Lambosaurus/Puzzlebox-HW/puzzlebox-main/Puzzlebox-HW.kicad_pcb

## KiCad design puzzlebox-main/Puzzlebox-HW.kicad_pcb (2025-12-28)

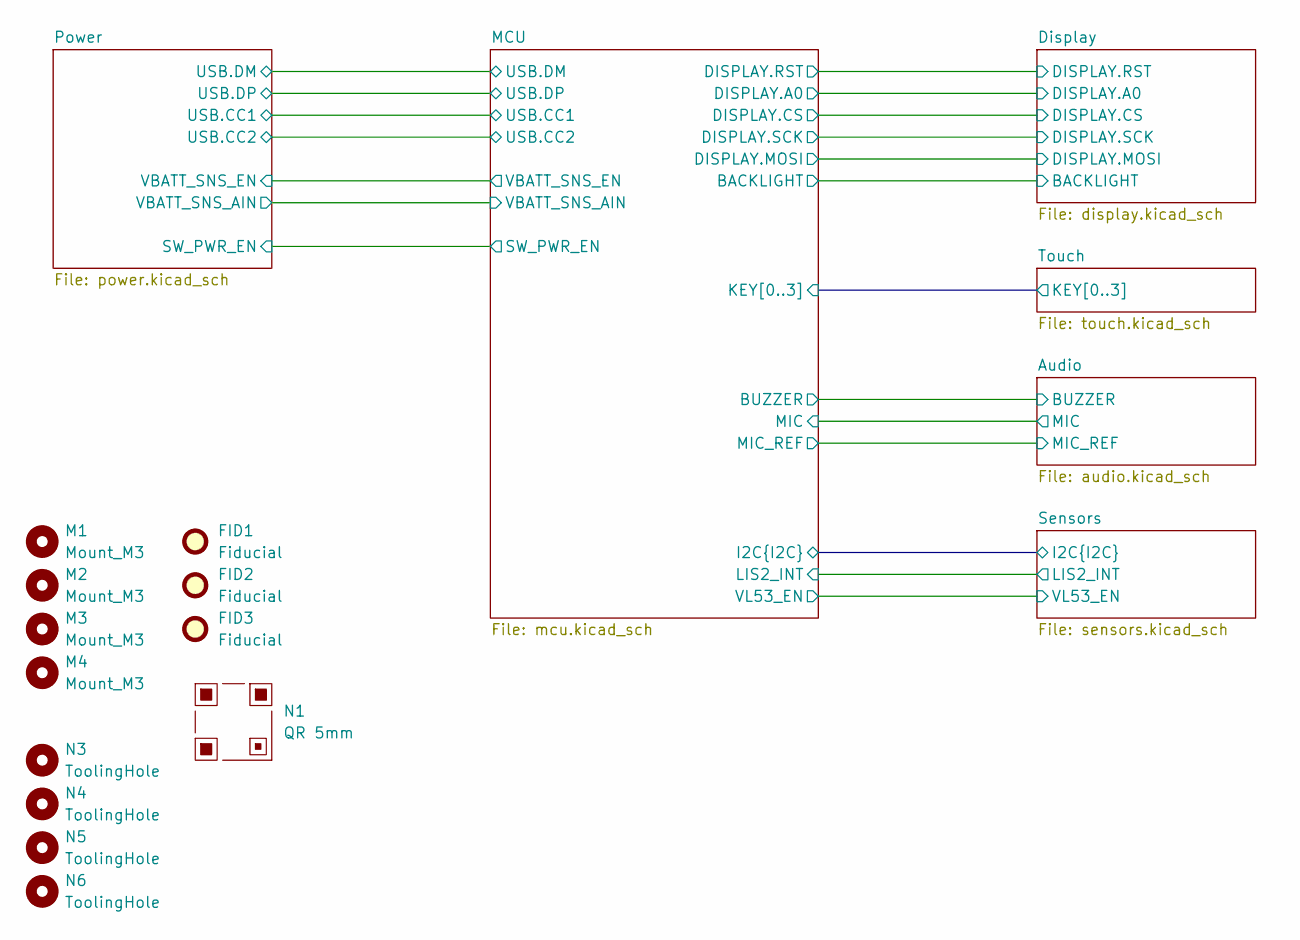
[picture p1: schematic Puzzlebox-HW.kicad_sch, Puzzlebox]

Parts:
FID1, FID2, FID3: Fiducial; Fiducial_2mm
M1, M2, M3, M4: Mount_M3
N1: QR 5mm; QR_5mm_JLC
N3, N4, N5, N6: ToolingHole; ToolingHole_1mm

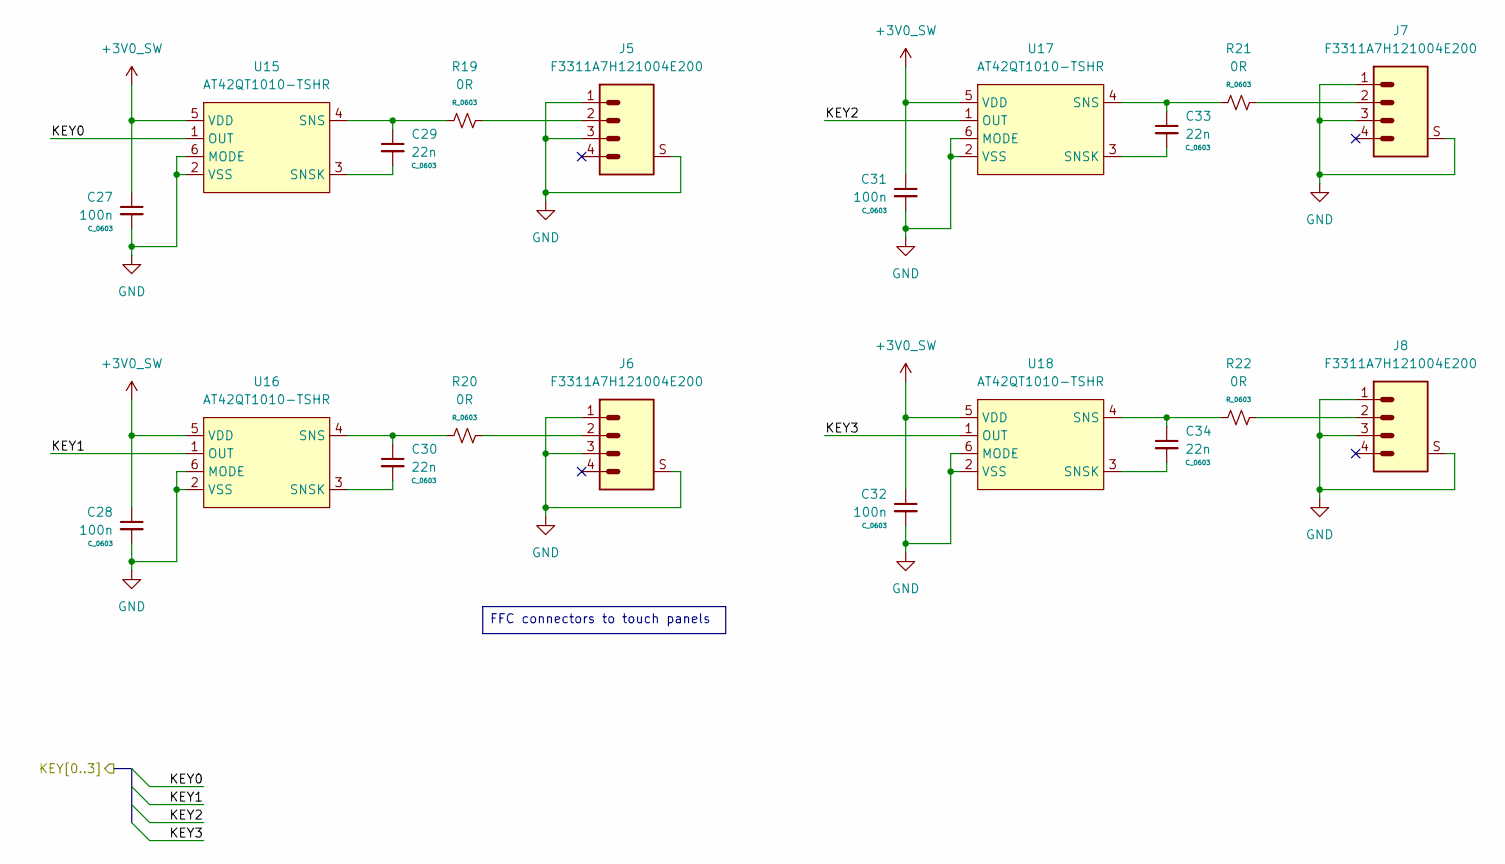
[picture p2: schematic touch.kicad_sch, Puzzlebox]

Parts:
C27, C28, C31, C32: 100n; C_0603
C29, C30, C33, C34: 22n; C_0603
J5, J6, J7, J8: F3311A7H121004E200
R19, R20, R21, R22: 0R; R_0603
U15, U16, U17, U18: AT42QT1010-TSHR; SOT23_6

Connections:
+3V0_SW: C27.1, C28.1, C31.1, C32.1, U15.5 (VDD), U16.5 (VDD), U17.5 (VDD), U18.5 (VDD); also elsewhere on the board
/MCU/KEY0: U15.1 (OUT); also elsewhere on the board
/MCU/KEY1: U16.1 (OUT); also elsewhere on the board
/MCU/KEY2: U17.1 (OUT); also elsewhere on the board
/MCU/KEY3: U18.1 (OUT); also elsewhere on the board
GND: C27.2, C28.2, C31.2, C32.2, J5.1, J5.3, J5.S, J6.1, J6.3, J6.S, J7.1, J7.3, J7.S, J8.1, J8.3, J8.S, U15.2 (VSS), U15.6 (MODE), U16.2 (VSS), U16.6 (MODE), U17.2 (VSS), U17.6 (MODE), U18.2 (VSS), U18.6 (MODE); also elsewhere on the board
unnamed: J5.2, R19.2
unnamed: J6.2, R20.2
unnamed: J7.2, R21.2
unnamed: J8.2, R22.2
unnamed: C29.1, R19.1, U15.4 (SNS)
unnamed: C29.2, U15.3 (SNSK)
unnamed: C30.1, R20.1, U16.4 (SNS)
unnamed: C30.2, U16.3 (SNSK)
unnamed: C33.1, R21.1, U17.4 (SNS)
unnamed: C33.2, U17.3 (SNSK)
unnamed: C34.1, R22.1, U18.4 (SNS)
unnamed: C34.2, U18.3 (SNSK)

Notes on the sheet:
FFC connectors to touch panels

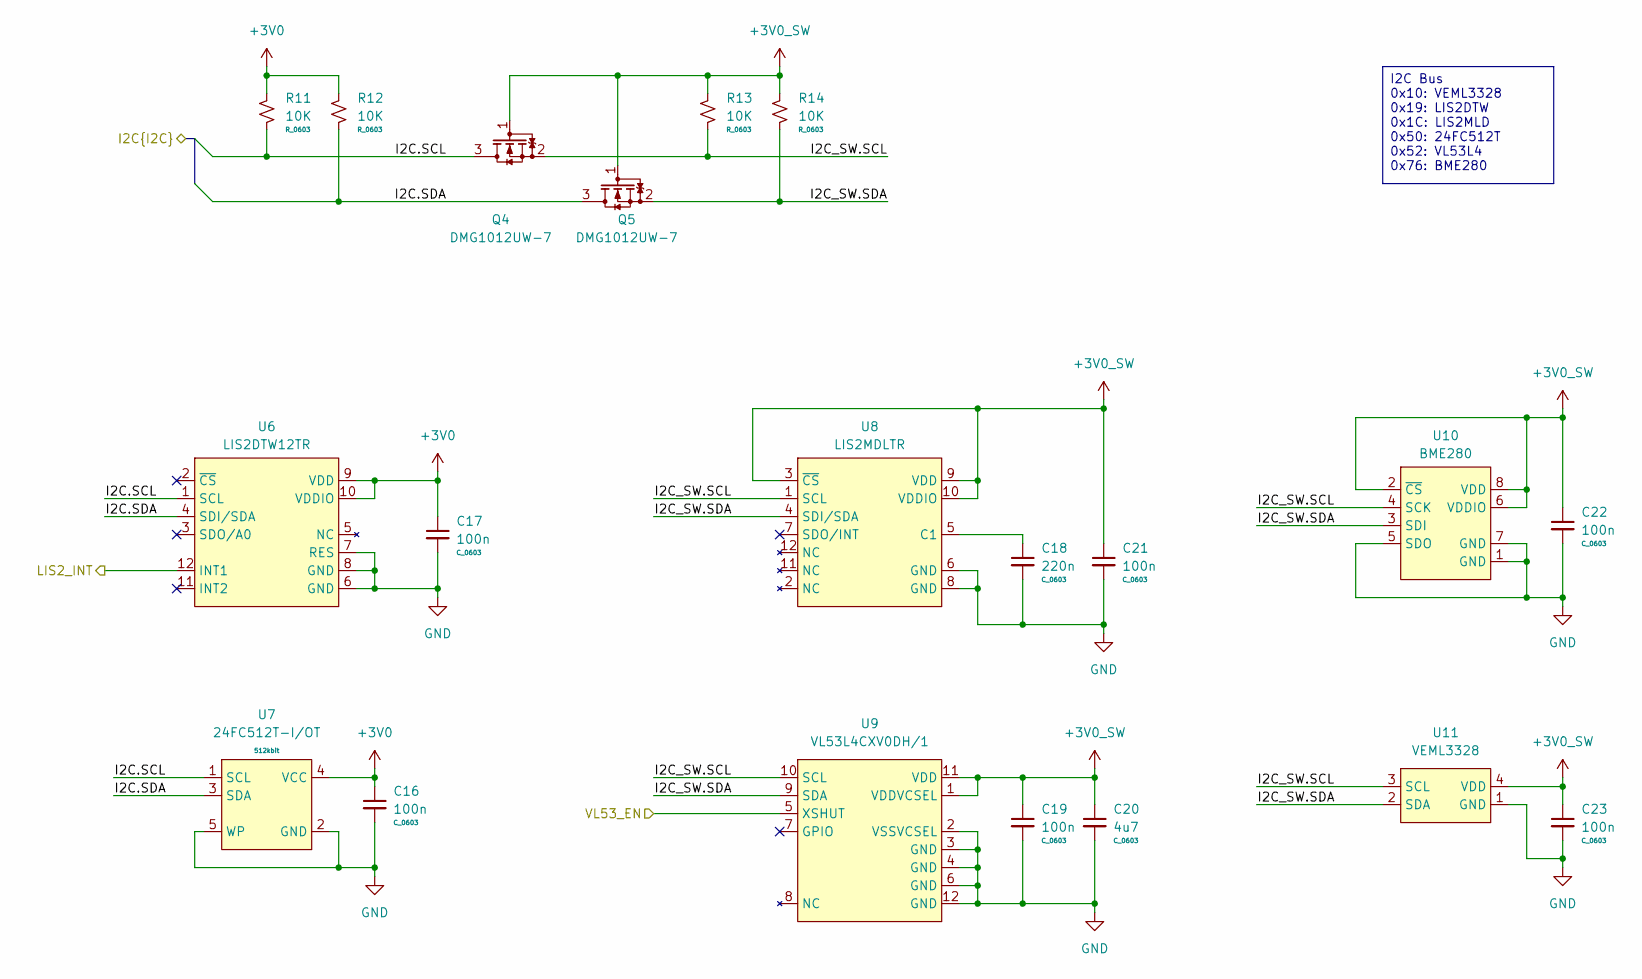
[picture p3: schematic sensors.kicad_sch, Puzzlebox]

Parts:
C16, C17, C19, C21, C22, C23: 100n; C_0603
C18: 220n; C_0603
C20: 4u7; C_0603
Q4, Q5: DMG1012UW-7; SC70-3
R11, R12, R13, R14: 10K; R_0603
U6: LIS2DTW12TR; LGA12_05_2x2_ST
U7: 24FC512T-I/OT; SOT23_5
U8: LIS2MDLTR; LGA12_05_2x2_ST
U9: VL53L4CXV0DH/1; ST_VL53Lxx
U10: BME280; LGA8_025_2.5x1_Bosch
U11: VEML3328; Vishay_80216OPLGA4L

Connections:
+3V0: C16.1, C17.1, R11.1, R12.1, U6.9 (VDD), U6.10 (VDDIO), U7.4 (VCC); also elsewhere on the board
+3V0_SW: C19.1, C20.1, C21.1, C22.1, C23.1, Q4.1 (G), Q5.1 (G), R13.1, R14.1, U8.3 (~CS), U8.9 (VDD), U8.10 (VDDIO), U9.1 (VDDVCSEL), U9.11 (VDD), U10.2 (~CS), U10.6 (VDDIO), U10.8 (VDD), U11.4 (VDD); also elsewhere on the board
/MCU/I2C.SCL: Q4.3 (D), R11.2, U6.1 (SCL), U7.1 (SCL); also elsewhere on the board
/MCU/I2C.SDA: Q5.3 (D), R12.2, U6.4 (SDI/SDA), U7.3 (SDA); also elsewhere on the board
/MCU/LIS2_INT: U6.12 (INT1); also elsewhere on the board
/MCU/VL53_EN: U9.5 (XSHUT); also elsewhere on the board
/Sensors/I2C_SW.SCL: Q4.2 (S), R13.2, U8.1 (SCL), U9.10 (SCL), U10.4 (SCK), U11.3 (SCL)
/Sensors/I2C_SW.SDA: Q5.2 (S), R14.2, U8.4 (SDI/SDA), U9.9 (SDA), U10.3 (SDI), U11.2 (SDA)
GND: C16.2, C17.2, C18.2, C19.2, C20.2, C21.2, C22.2, C23.2, U6.6 (GND), U6.7 (RES), U6.8 (GND), U7.2 (GND), U7.5 (WP), U8.6 (GND), U8.8 (GND), U9.2 (VSSVCSEL), U9.3 (GND), U9.4 (GND), U9.6 (GND), U9.12 (GND), U10.1 (GND), U10.5 (SDO), U10.7 (GND), U11.1 (GND); also elsewhere on the board
unnamed: C18.1, U8.5 (C1)

Notes on the sheet:
I2C Bus 0x10: VEML3328 0x19: LIS2DTW 0x1C: LIS2MLD 0x50: 24FC512T 0x52: VL53L4 0x76: BME280

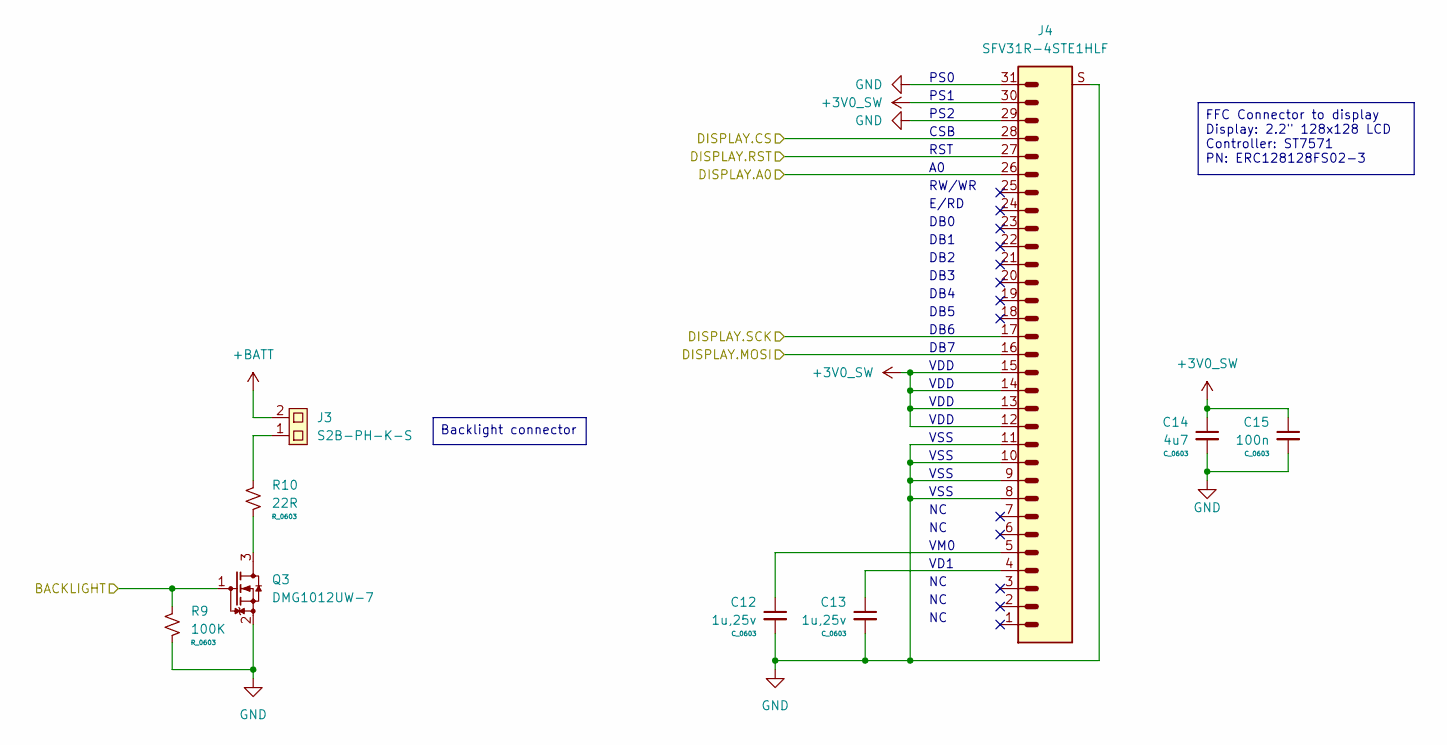
[picture p4: schematic display.kicad_sch, Puzzlebox]

Parts:
C12, C13: 1u,25v; C_0603
C14: 4u7; C_0603
C15: 100n; C_0603
J3: S2B-PH-K-S; JST-S2B-PH-K-S
J4: SFV31R-4STE1HLF
Q3: DMG1012UW-7; SC70-3
R9: 100K; R_0603
R10: 22R; R_0603

Connections:
+3V0_SW: C14.1, C15.1, J4.12, J4.13, J4.14, J4.15, J4.30; also elsewhere on the board
+BATT: J3.2; also elsewhere on the board
/Display/BACKLIGHT: Q3.1 (G), R9.1; also elsewhere on the board
/Display/DISPLAY.A0: J4.26; also elsewhere on the board
/Display/DISPLAY.CS: J4.28; also elsewhere on the board
/Display/DISPLAY.MOSI: J4.16; also elsewhere on the board
/Display/DISPLAY.RST: J4.27; also elsewhere on the board
/Display/DISPLAY.SCK: J4.17; also elsewhere on the board
GND: C12.2, C13.2, C14.2, C15.2, J4.8, J4.9, J4.10, J4.11, J4.29, J4.31, J4.S, Q3.2 (S), R9.2; also elsewhere on the board
unnamed: C12.1, J4.5
unnamed: C13.1, J4.4
unnamed: J3.1, R10.1
unnamed: Q3.3 (D), R10.2

Notes on the sheet:
PS0
E/RD
VSS
PS2
VM0
VD1
DB4
DB7
RST
DB6
RW/WR
PS1
DB0
VDD
DB1
DB3
DB2
DB5
CSB
FFC Connector to display Display: 2.2" 128x128 LCD Controller: ST7571 PN: ERC128128FS02-3
Backlight connector

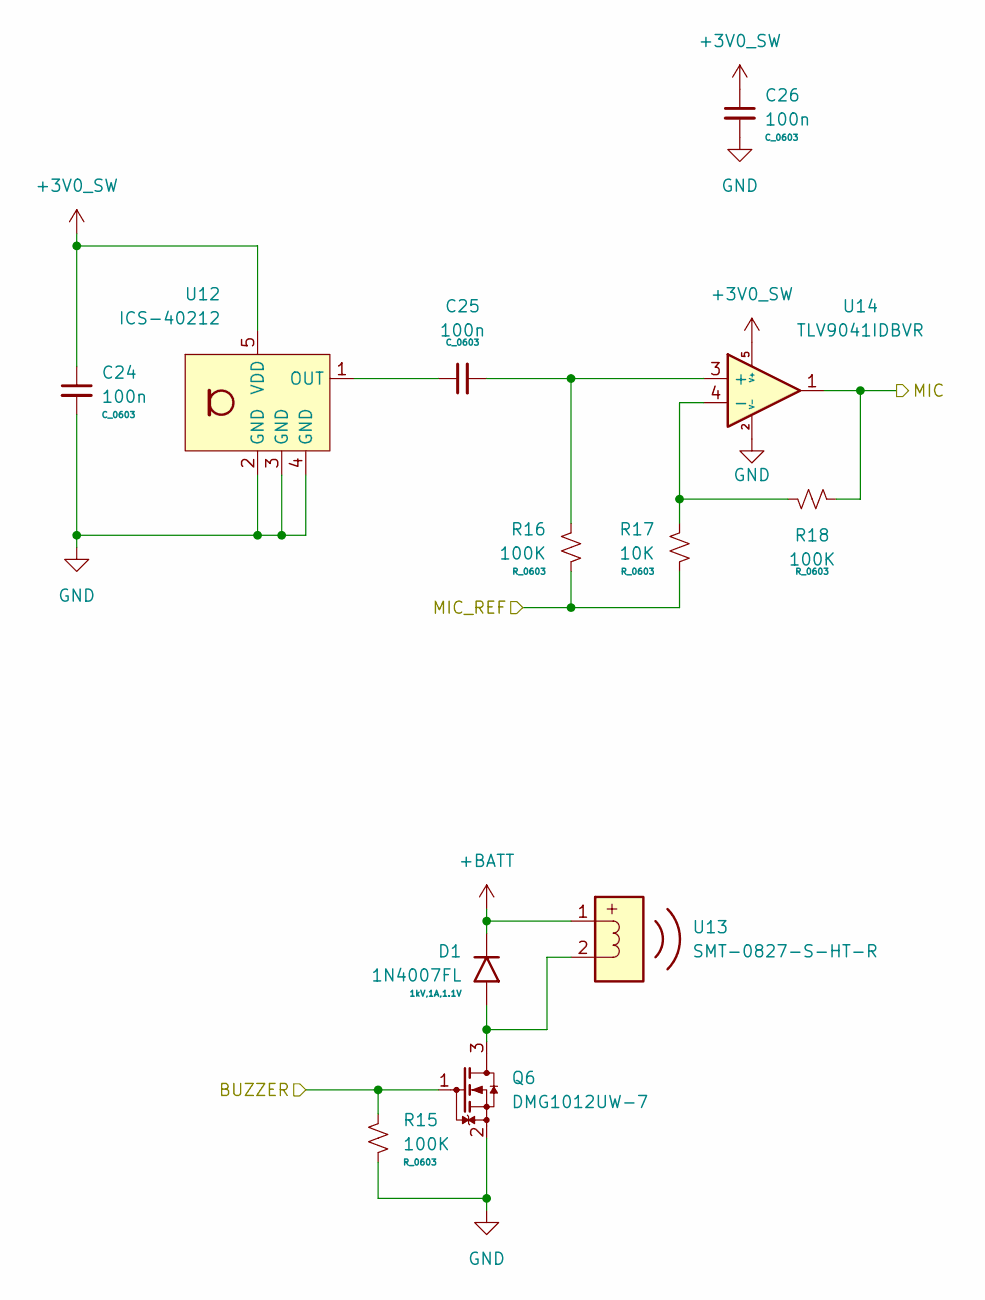
[picture p5: schematic audio.kicad_sch, Puzzlebox]

Parts:
C24, C25, C26: 100n; C_0603
D1: 1N4007FL; D_SOD_123
Q6: DMG1012UW-7; SC70-3
R15, R16, R18: 100K; R_0603
R17: 10K; R_0603
U12: ICS-40212
U13: SMT-0827-S-HT-R; SMT_0827_S_HT_R
U14: TLV9041IDBVR; SOT23_5

Connections:
+3V0_SW: C24.1, C26.1, U12.5 (VDD), U14.5 (V+); also elsewhere on the board
+BATT: D1.1, U13.1; also elsewhere on the board
/Audio/BUZZER: Q6.1 (G), R15.1; also elsewhere on the board
/Audio/MIC: R18.2, U14.1; also elsewhere on the board
/Audio/MIC_REF: R16.2, R17.1; also elsewhere on the board
GND: C24.2, C26.2, Q6.2 (S), R15.2, U12.2 (GND), U12.3 (GND), U12.4 (GND), U14.2 (V-); also elsewhere on the board
unnamed: D1.2, Q6.3 (D), U13.2
unnamed: C25.1, U12.1 (OUT)
unnamed: C25.2, R16.1, U14.3 (+)
unnamed: R17.2, R18.1, U14.4 (-)

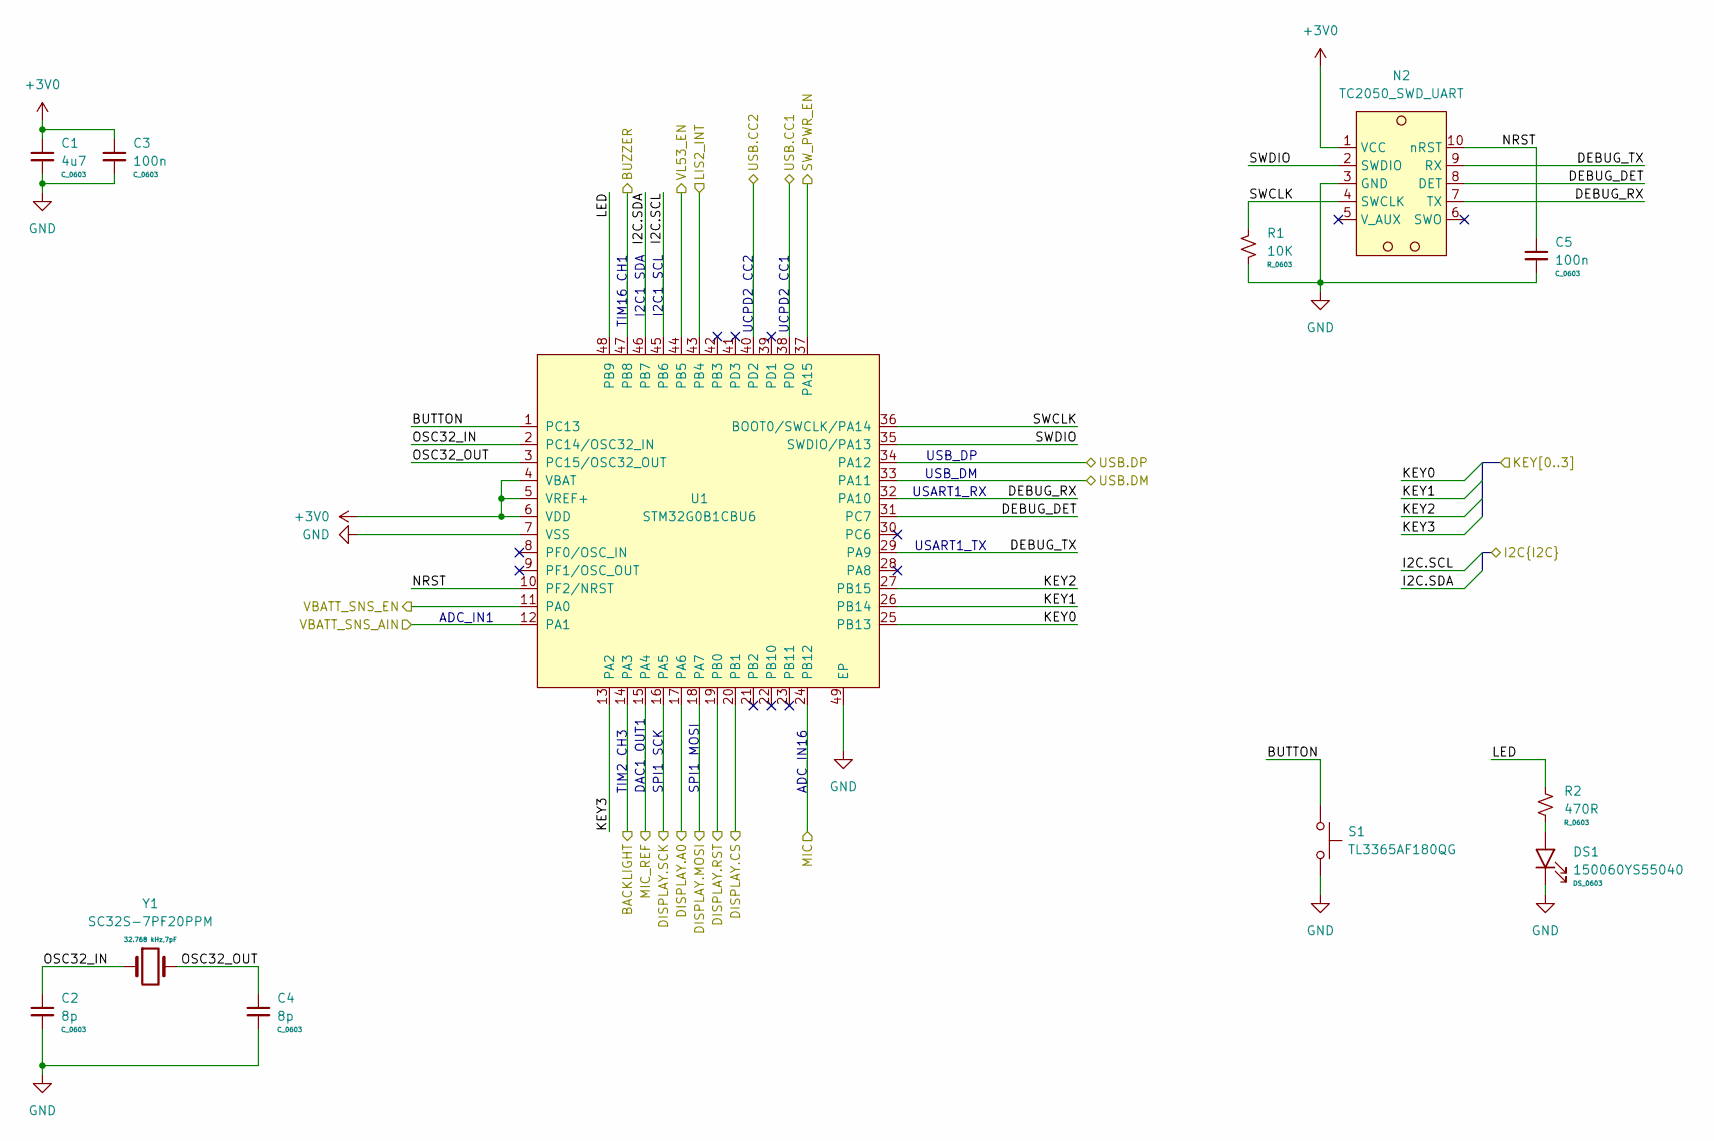
[picture p6: schematic mcu.kicad_sch, Puzzlebox]

Parts:
C1: 4u7; C_0603
C2, C4: 8p; C_0603
C3, C5: 100n; C_0603
DS1: 150060YS55040; DS_0603
N2: TC2050_SWD_UART; TagConnect_TC2050
R1: 10K; R_0603
R2: 470R; R_0603
S1: TL3365AF180QG; Button_4.2x3.2
U1: STM32G0B1CBU6; QFN48_05_7x7_EP
Y1: SC32S-7PF20PPM; Crystal_SMD2_3.2x1.5

Connections:
+3V0: C1.1, C3.1, N2.1 (VCC), U1.4 (VBAT), U1.5 (VREF+), U1.6 (VDD); also elsewhere on the board
/Audio/BUZZER: U1.47 (PB8); also elsewhere on the board
/Audio/MIC: U1.24 (PB12); also elsewhere on the board
/Audio/MIC_REF: U1.15 (PA4); also elsewhere on the board
/Display/BACKLIGHT: U1.14 (PA3); also elsewhere on the board
/Display/DISPLAY.A0: U1.17 (PA6); also elsewhere on the board
/Display/DISPLAY.CS: U1.20 (PB1); also elsewhere on the board
/Display/DISPLAY.MOSI: U1.18 (PA7); also elsewhere on the board
/Display/DISPLAY.RST: U1.19 (PB0); also elsewhere on the board
/Display/DISPLAY.SCK: U1.16 (PA5); also elsewhere on the board
/MCU/BUTTON: S1.1, U1.1 (PC13)
/MCU/DEBUG_DET: N2.8 (DET), U1.31 (PC7)
/MCU/DEBUG_RX: N2.7 (TX), U1.32 (PA10)
/MCU/DEBUG_TX: N2.9 (RX), U1.29 (PA9)
/MCU/I2C.SCL: U1.45 (PB6); also elsewhere on the board
/MCU/I2C.SDA: U1.46 (PB7); also elsewhere on the board
/MCU/KEY0: U1.25 (PB13); also elsewhere on the board
/MCU/KEY1: U1.26 (PB14); also elsewhere on the board
/MCU/KEY2: U1.27 (PB15); also elsewhere on the board
/MCU/KEY3: U1.13 (PA2); also elsewhere on the board
/MCU/LED: R2.1, U1.48 (PB9)
/MCU/LIS2_INT: U1.43 (PB4); also elsewhere on the board
/MCU/NRST: C5.1, N2.10 (nRST), U1.10 (PF2/NRST)
/MCU/OSC32_IN: C2.1, U1.2 (PC14/OSC32_IN), Y1.1
/MCU/OSC32_OUT: C4.1, U1.3 (PC15/OSC32_OUT), Y1.2
/MCU/SWCLK: N2.4 (SWCLK), R1.1, U1.36 (BOOT0/SWCLK/PA14)
/MCU/SWDIO: N2.2 (SWDIO), U1.35 (SWDIO/PA13)
/MCU/SW_PWR_EN: U1.37 (PA15); also elsewhere on the board
/MCU/USB.CC1: U1.38 (PD0); also elsewhere on the board
/MCU/USB.CC2: U1.40 (PD2); also elsewhere on the board
/MCU/USB.DM: U1.33 (PA11); also elsewhere on the board
/MCU/USB.DP: U1.34 (PA12); also elsewhere on the board
/MCU/VBATT_SNS_AIN: U1.12 (PA1); also elsewhere on the board
/MCU/VBATT_SNS_EN: U1.11 (PA0); also elsewhere on the board
/MCU/VL53_EN: U1.44 (PB5); also elsewhere on the board
GND: C1.2, C2.2, C3.2, C4.2, C5.2, DS1.1 (K), N2.3 (GND), R1.2, S1.2, U1.7 (VSS), U1.49 (EP); also elsewhere on the board
unnamed: DS1.2 (A), R2.2

Notes on the sheet:
UCPD2_CC1
SPI1_SCK
USB_DM
SPI1_MOSI
TIM16_CH1
UCPD2_CC2
ADC_IN1
USB_DP
DAC1_OUT1
TIM2_CH3
I2C1_SDA
I2C1_SCL
USART1_TX
USART1_RX
ADC_IN16

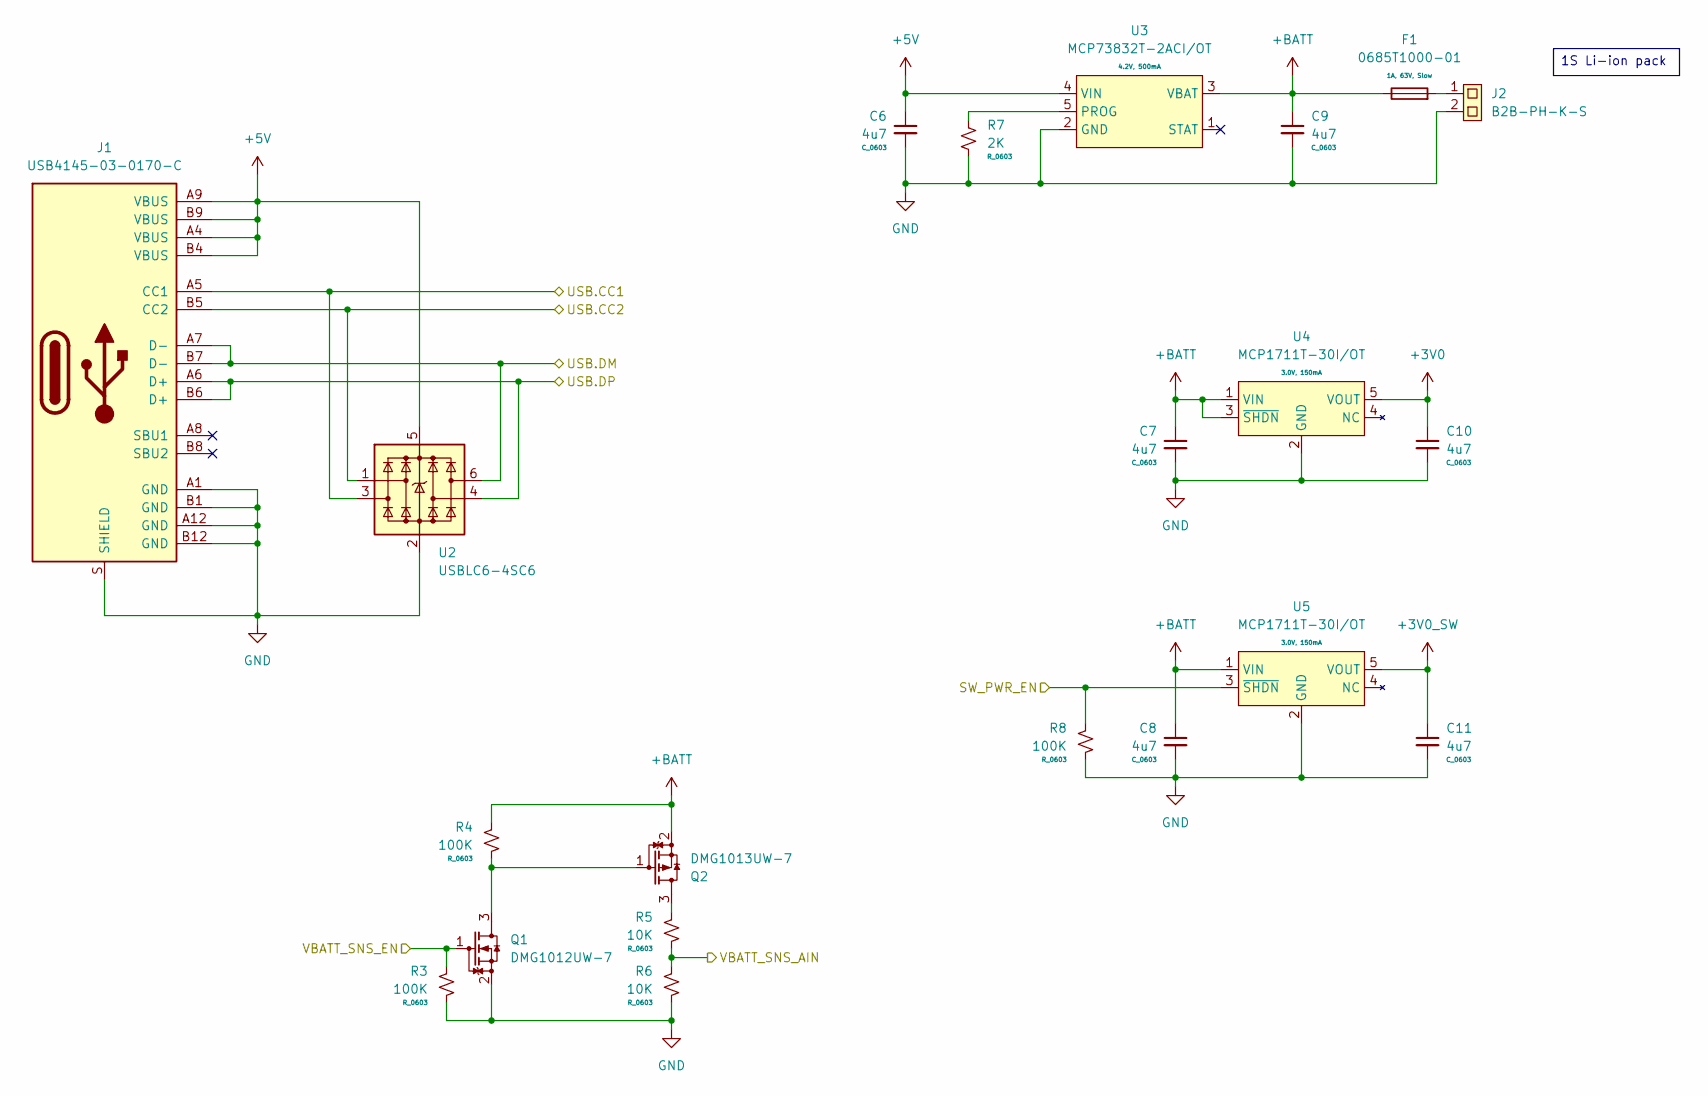
[picture p7: schematic power.kicad_sch, Puzzlebox]

Parts:
C6, C7, C8, C9, C10, C11: 4u7; C_0603
F1: 0685T1000-01; F_1206
J1: USB4145-03-0170-C; USB_C_USB4145-03-0170-C
J2: B2B-PH-K-S; JST_B2B-PH-K
Q1: DMG1012UW-7; SC70-3
Q2: DMG1013UW-7; SC70-3
R3, R4, R8: 100K; R_0603
R5, R6: 10K; R_0603
R7: 2K; R_0603
U2: USBLC6-4SC6; SOT23_6
U3: MCP73832T-2ACI/OT; SOT23_5
U4, U5: MCP1711T-30I/OT; SOT23_5

Connections:
+3V0: C10.1, U4.5 (VOUT); also elsewhere on the board
+3V0_SW: C11.1, U5.5 (VOUT); also elsewhere on the board
+5V: C6.1, J1.A4 (VBUS), J1.A9 (VBUS), J1.B4 (VBUS), J1.B9 (VBUS), U2.5, U3.4 (VIN)
+BATT: C7.1, C8.1, C9.1, F1.1, Q2.2 (S), R4.2, U3.3 (VBAT), U4.1 (VIN), U4.3 (~SHDN), U5.1 (VIN); also elsewhere on the board
/MCU/SW_PWR_EN: R8.2, U5.3 (~SHDN); also elsewhere on the board
/MCU/USB.CC1: J1.A5 (CC1), U2.3; also elsewhere on the board
/MCU/USB.CC2: J1.B5 (CC2), U2.1; also elsewhere on the board
/MCU/USB.DM: J1.A7 (D-), J1.B7 (D-), U2.6; also elsewhere on the board
/MCU/USB.DP: J1.A6 (D+), J1.B6 (D+), U2.4; also elsewhere on the board
/MCU/VBATT_SNS_AIN: R5.1, R6.2; also elsewhere on the board
/MCU/VBATT_SNS_EN: Q1.1 (G), R3.2; also elsewhere on the board
GND: C6.2, C7.2, C8.2, C9.2, C10.2, C11.2, J1.A1 (GND), J1.A12 (GND), J1.B1 (GND), J1.B12 (GND), J1.S (SHIELD), J2.2, Q1.2 (S), R3.1, R6.1, R7.2, R8.1, U2.2, U3.2 (GND), U4.2 (GND), U5.2 (GND); also elsewhere on the board
unnamed: F1.2, J2.1
unnamed: Q1.3 (D), Q2.1 (G), R4.1
unnamed: Q2.3 (D), R5.2
unnamed: R7.1, U3.5 (PROG)

Notes on the sheet:
1S Li-ion pack

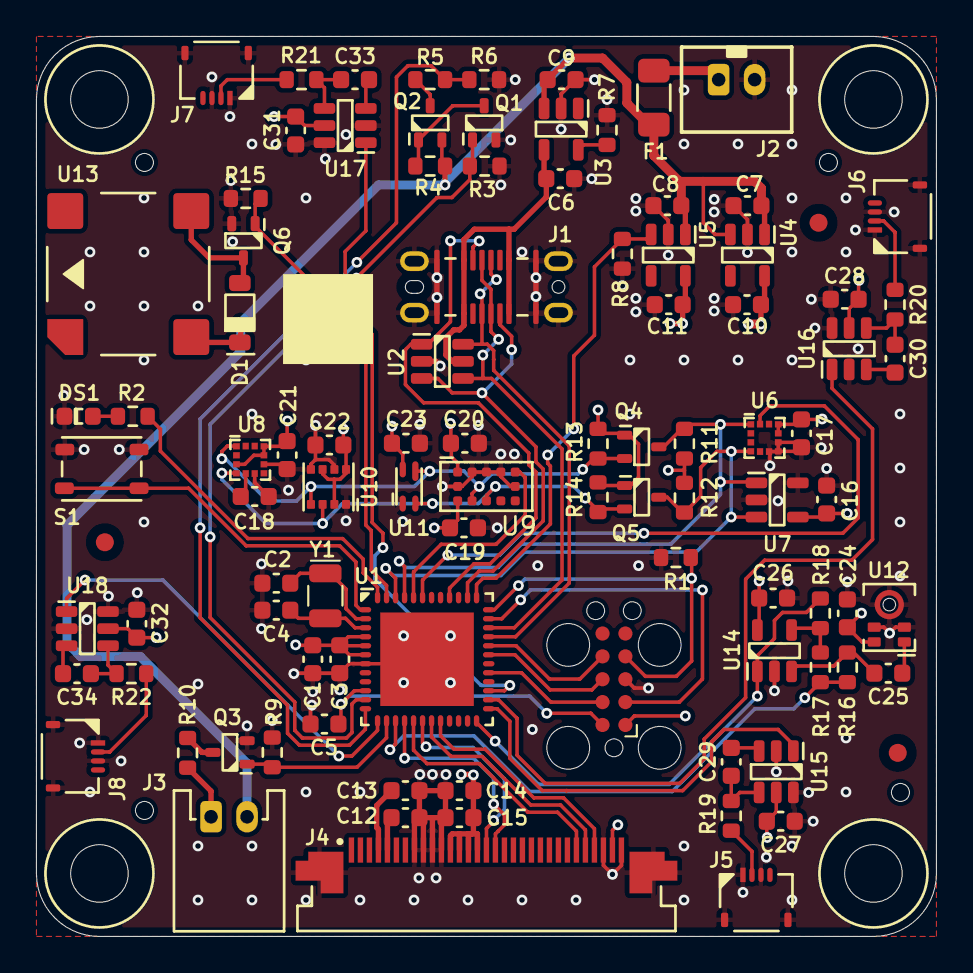
[picture p8: board Puzzlebox-HW.kicad_pcb from above]

Board: 4 copper layers, 50.0 x 50.0 mm, 106 parts (0 on the bottom side), 67 nets.
