Lambosaurus/Puzzlebox-HW/(commit log)

2025-12-27 Initial schematics
    [Puzzlebox-HW.kicad_pcb, Puzzlebox-HW.kicad_sch, audio.kicad_sch, display.kicad_sch, mcu.kicad_sch, power.kicad_sch, sensors.kicad_sch, touch.kicad_sch]
2025-12-27 Initial layout
    [Puzzlebox-HW.kicad_pcb, Puzzlebox-HW.kicad_sch, display.kicad_sch, mcu.kicad_sch, power.kicad_sch, touch.kicad_sch]
2025-12-28 Add some notes. Configure outputs.
    [Puzzlebox-HW.kicad_pcb, display.kicad_sch, power.kicad_sch, touch.kicad_sch]
2025-12-28 Move project into subdir
    [Puzzlebox-HW.kicad_pcb, Puzzlebox-HW.kicad_sch, audio.kicad_sch, display.kicad_sch, mcu.kicad_sch, power.kicad_sch, sensors.kicad_sch, touch.kicad_sch]
2025-12-28 Add touch key
    [Puzzlebox-Key.kicad_pcb, Puzzlebox-Key.kicad_sch]
2025-12-29 Use layer names
    [Puzzlebox-Key.kicad_pcb]
